BenhurLeeAK/soil-health-monitor/cad/source/tree_snapper.SLDPRT

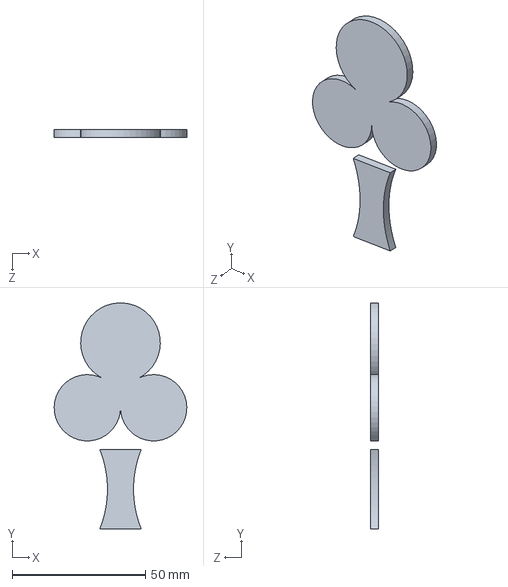
[picture p13: CAD file, 2026-11-05]
cad/source/tree_snapper.SLDPRT
49.8 x 84.8 x 3.00 mm
