BenhurLeeAK/soil-health-monitor/cad/source/agri_product_back_door.SLDPRT

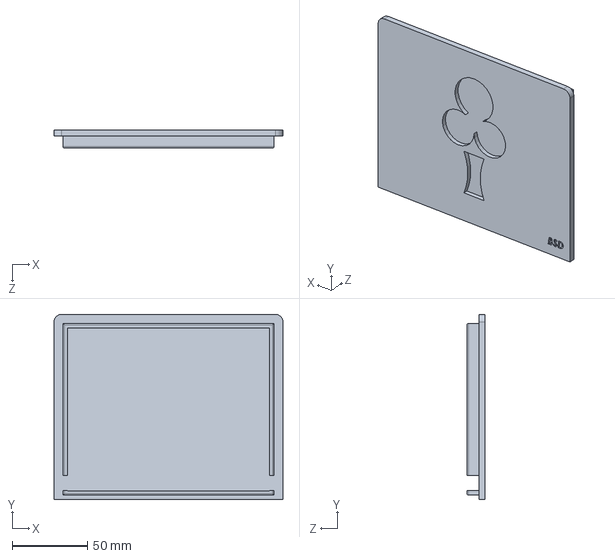
[picture p14: CAD file, 2026-11-05]
cad/source/agri_product_back_door.SLDPRT
151.9 x 122.9 x 12.0 mm
