BenhurLeeAK/soil-health-monitor/cad/source/agri_product_casing.SLDPRT

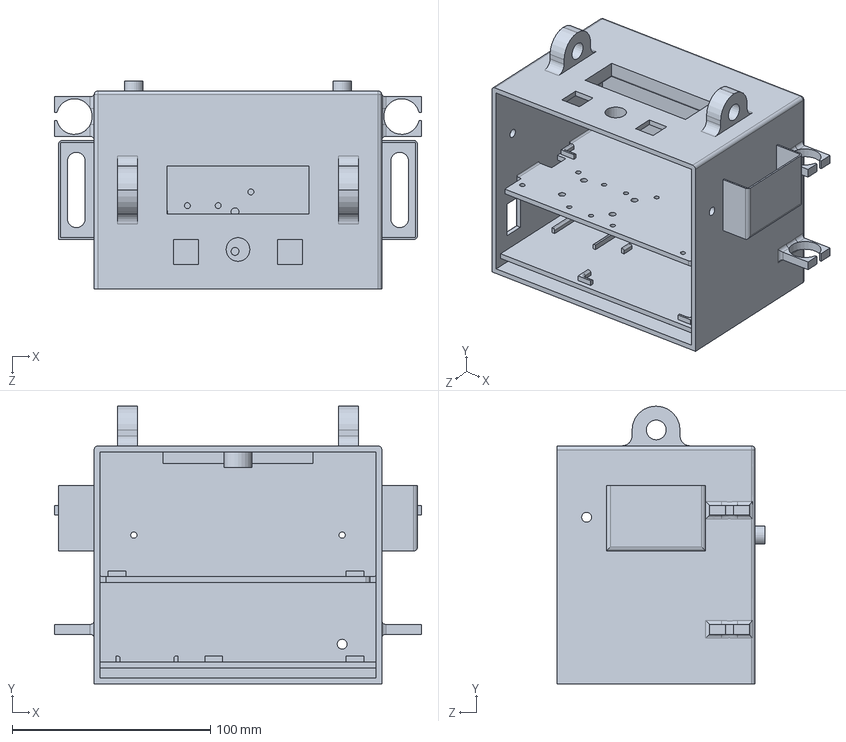
[picture p15: CAD file, 2026-11-05]
cad/source/agri_product_casing.SLDPRT
185.0 x 140.0 x 105.0 mm
