BenhurLeeAK/soil-health-monitor/cad/source/agri_product_holder.SLDPRT

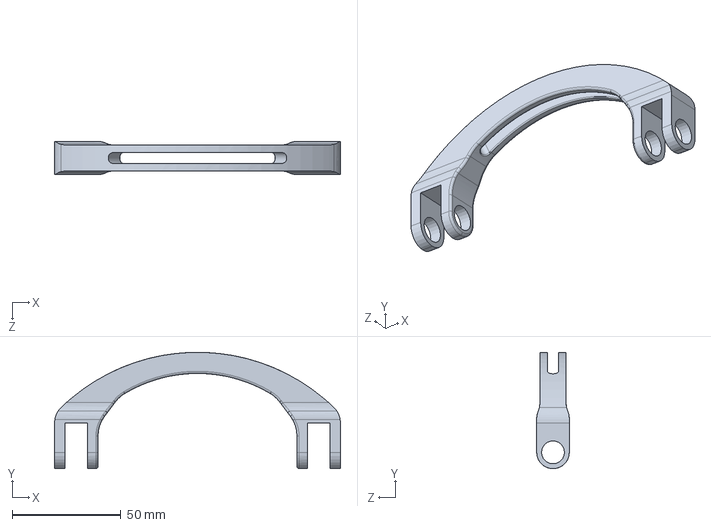
[picture p16: CAD file, 2026-11-05]
cad/source/agri_product_holder.SLDPRT
131.2 x 53.4 x 15.0 mm
