BenhurLeeAK/soil-health-monitor/cad/source/holder_nut.SLDPRT

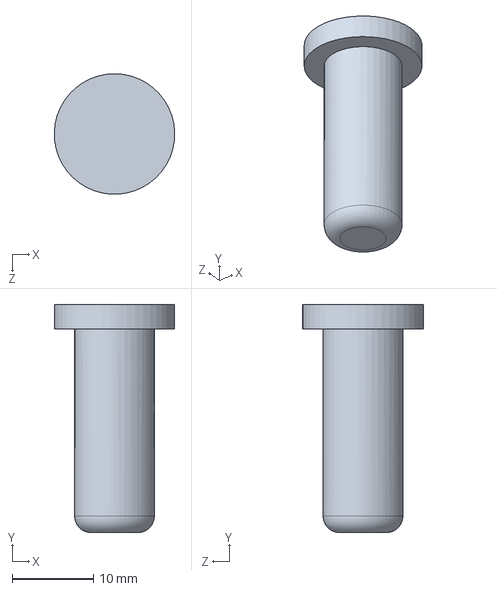
[picture p17: CAD file, 2026-11-05]
cad/source/holder_nut.SLDPRT
14.8 x 28.0 x 14.8 mm
