BenhurLeeAK/soil-health-monitor/cad/source/agro-_MSME.SLDASM

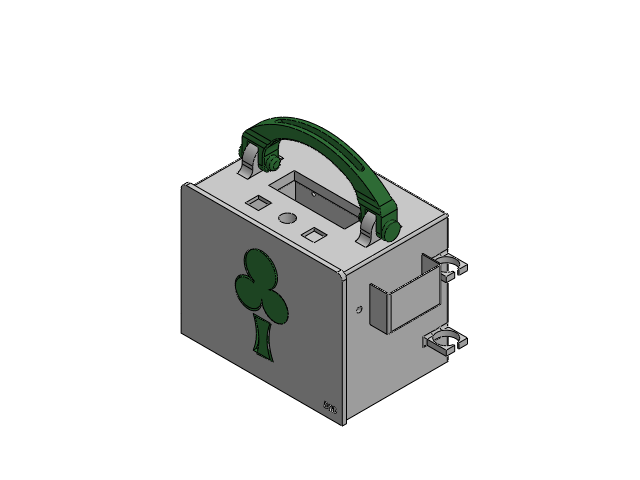
[picture p18: CAD file, 2026-11-05]
cad/source/agro-_MSME.SLDASM
agri product casing
agri product holder
holder nut x 2
agri product back door
tree snapper
